greesh02/digit_recognition_with_point_to_point_translation/bot images/bottom.jpeg

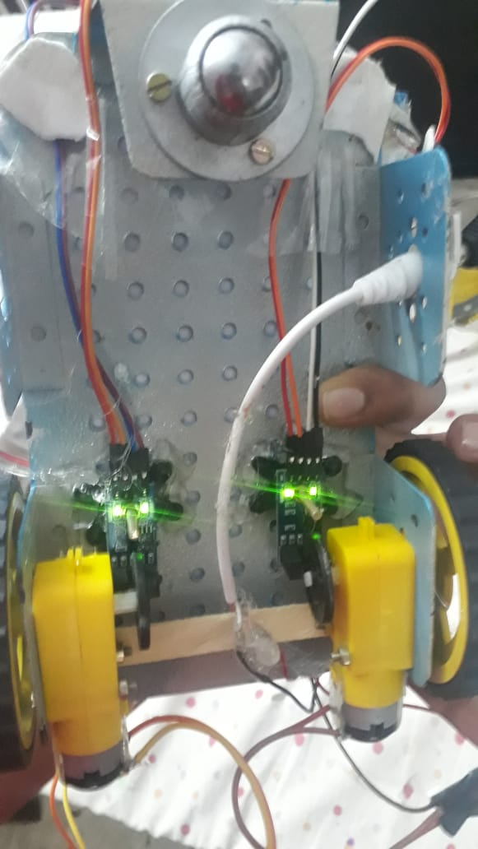
bot images/bottom.jpeg
