greesh02/digit_recognition_with_point_to_point_translation/bot images/encoder_IR.jpeg

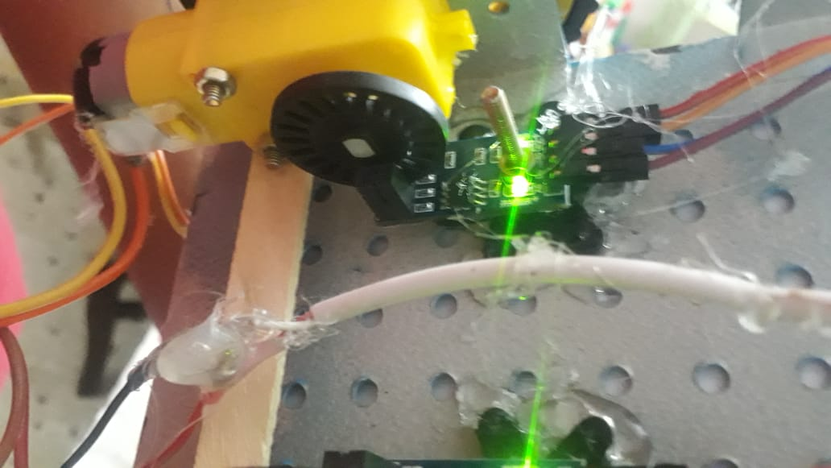
bot images/encoder_IR.jpeg
