greesh02/digit_recognition_with_point_to_point_translation/bot images/top.jpeg

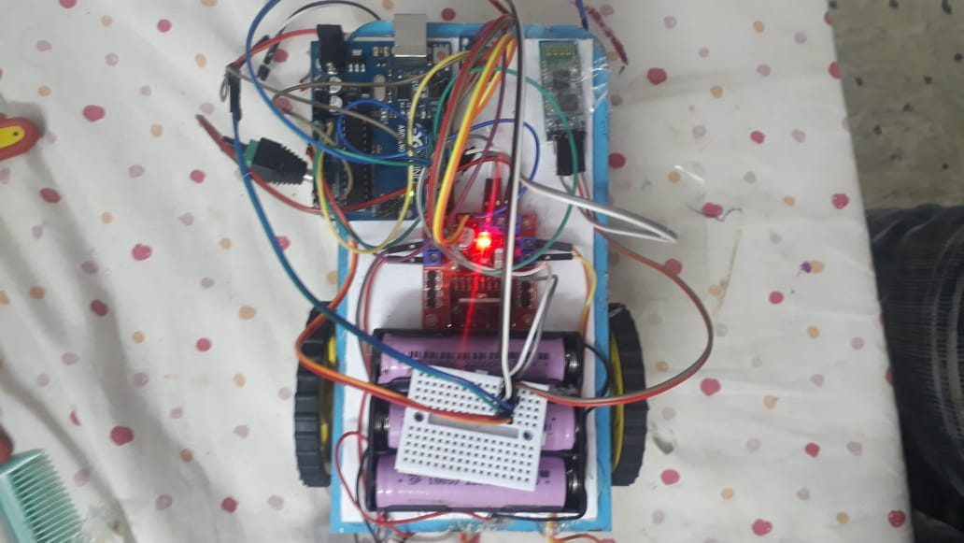
bot images/top.jpeg
